pedroruizf/cansat/arduino/cansat_accesible.pdf

# CANSAT accesible con ArduinoBlocks y Processing

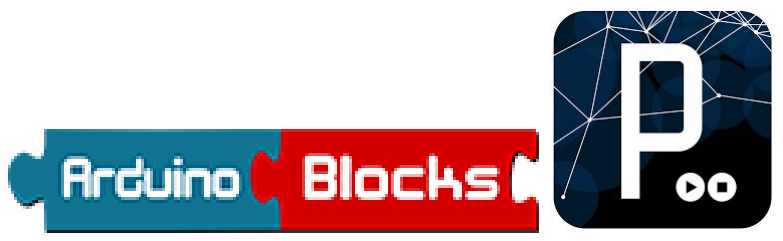
[picture p11: figure]

Por: Pedro Ruiz Fernández @pedroruizf

Con la colaboración inestimable de Equipo Sotosat (IES Pedro Soto de Rojas), Lorenzo Olmo, Manuel Hidalgo @leobotmanuel, y Pepe Alcaide

Versión 28/10/2020

Licencia

Nota Importante: La Información compartida en este documento está realizada por profesor y equipo novato en CANSAT, así como todo los dispositivos y su programación están en fase de pruebas, por tanto, hay que tomarla con cautela y provisionalidad.

Introducción | 2
Información general | 2
Paracaidas | 2
Cálculo | 2
Trazado | 3
Enlaces complementarios | 4
Estructura | 5
Comunicaciones por radio (antenas) | 6
Software | 7
Misión Primaria | 7
Solución Electrónica con Arduino | 7
Componentes y piezas: | 7
Pin-out de Cansat con Arduino Mega 2560 Pro Mini y esquema con fritzing | 10
Alimentación de Arduino Mega | 12
Programa en Arduinoblocks | 13
Programa de estación base (PC) en processing | 15
Misión Secundaria | 17
Telemetetría avanzada, tratatamiento y graficado de datos | 17
Proyecto científico | 19
Objetivos | 19
Imágenes | 19
Vídeos | 22
Webs de interés | 22
Cansat accesible | 1

# Introducción

Se trata del desarrollo del proyecto CANSAT de manera que la parte electrónica sea asequible en cuanto a coste y complejidad en cuanto a programación. Para ello hemos elegido una plataforma de control Arduino Mega 2560 pro mini programada bajo la aplicación web “Arduinoblocks”, programación gráfica basada en bloques, además se ha implementado en “Processing” un programa para la estación base que filtra los posibles datos erróneos y los datos correctos los guarda en un fichero, también en la estación base se produce el graficado de los diferentes datos con el graficador libre KST. Esta combinación hace que el coste del proyecto para misiones primarias y secundarias fáciles sean asequibles, así como la programación de las mismas.

# Información general

- Web del proyecto: http://esero.es/cansat/
- Presentación:
https://docs.google.com/presentation/d/1Iyj4ezujqL82Y-b0kIbfKxgbNGXrmlXl3QwgTSKNW3c/edit?usp=sharing (https://docs.google.com/presentation/d/1Iyj4ezujqL82Y-b0kIbfKxgbNGXrmlXl3QwgTSKNW3c/edit?usp=sharing)
- Requisitos: http://esero.es/cansat/requisitos/
- Recursos asociados: http://esero.es/cansat/recursos-asociados/

# Paracaidas

El paracaidas está en fase de pruebas y todavía no se han realizado lanzamientos de prueba.

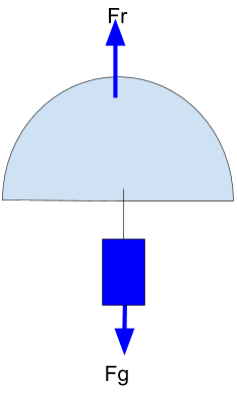
[picture p12: figure]

Cálculo
Datos de Cálculo: Masa cansat entre 300 y 350 g, Tiempo de vuelo recomendado máximo 120 s, Velocidad de descenso entre 6 y 12m/s (recomendadas entre 8 y 11m/s).
Para calcular vamos a igualar la fuerza de resistencia del paracaídas (Fr) a el peso que mueve el paracaídas (Fg=mg) hacia el suelo. Cuando estén igualadas deja de acelerar y la velocidad se convierte en constante, esa es la velocidad de caída.
ΣF = m.a, Fr − Fg = m.a, como Fr = Fg, 0 = m.a; a = 0
Fg=m.g (peso cansat).
Fr=½.r.Cd.A.V

2
(fuerza de resistencia del paracaídas)
- r = densidad del aire (1,22 Kg/m3)
- Cd = coeficiente de resistencia aerodinámico en paracaídas de forma hemiesférico su valor es 0,62.
- A = superficie del paracaídas (en nuestro caso semiesfera)
- V = velocidad de descenso
igualando las dos expresiones m.g = ½.r.Cd.A.V

2 de estas dos expresiones puedo despejar el área del paracaídas, A=2.(m.g)/r.Cd.V

2

Si la superficie del paracaídas es una semiesfera puedo calcular su diámetro, A=2.pi.R

2
, por tanto igualando
= | , despejando

2.m.g
r.Cd.V

2

2.Π.R

2 | R = √

m.g
r.Cd.V .Π

2
Para determinar la velocidad de caída y si la velocidad es constante (sin aceleración), tenemos que V=e/t, el cohete alcanza 1000 m de altura (espacio a recorrer) y el tiempo dijimos 120 s, por tanto …., ya tenemos la V, además tenemos la masa de nuestro cansat (de 300g a 350g), con lo cual ya tenemos todo para calcular nuestro radio o diámetro de paracaídas.

Trazado
Además hemos realizado una hoja de cálculo (https://drive.google.com/file/d/1-Z3dpShxpypyg2hHrPxrzzwptYT9jEAG/view?usp=sharing) para realizar los cálculos de la forma y dimensiones de nuestros gores (secciones) de nuestro paracaidas, en función del radio elegido y el número de secciones.
Cálculo de coordenadas:
- X=α.radio, posición x de los puntos del gore
- Y=(2.Π.radio.cosα)/(nº gores.2), posición y de los puntos del gore (hay dos una positiva y otra negativa simétricas)
radio (cm) | angulos (rad) (α) | angulos | x | y | y- | base
12 | 0 | 0 | 0 | 4,712388980384 69 | -4,712388980384 69 | 9,4247779607 6938
n.º gores | 0,174532 9251994 33 | 10 | 2,0943951023 932 | 4,640797203092 14 | -4,640797203092 14
8 | 0,349065 8503988 66 | 20 | 4,1887902047 8639 | 4,428197151140 32 | -4,428197151140 32
| 0,523598 7755982 99 | 30 | 6,2831853071 7959 | 4,081048569526 99 | -4,081048569526 99
| 0,698131 7007977 32 | 40 | 8,3775804095 7278 | 3,609899392238 8 | -3,609899392238 8
| 0,872664 6259971 65 | 50 | 10,471975511 966 | 3,029065248614 66 | -3,029065248614 66
| 1,047197 5511966 | 60 | 12,566370614 3592 | 2,356194490192 35 | -2,356194490192 35
| 1,221730 4763960 3 | 70 | 14,660765716 7524 | 1,611731954477 47 | -1,611731954477 47

1,396263 4015954 6 | 80 | 16,755160819 1456 | 0,818297758901 526 | -0,818297758901 526
1,570796 3267949 | 90 | 18,849555921 5388 | 2,885506040582 68E-16 | -2,885506040582 68E-16

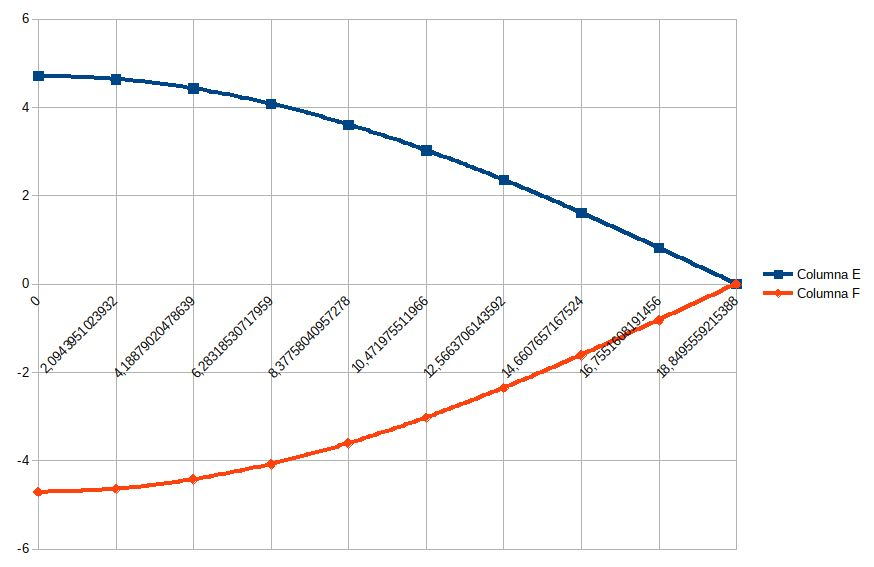
[picture p13: figure]

Enlaces complementarios
- Documento sobre paracaidas: http://esero.es/wp-content/uploads/2019/10/T10_Parachute_Design.pdf
- Calculo de paracaidas: http://www.rocketmime.com/rockets/descent.html
- Construcción | de | paracaidas | hemiesférico:
https://www.rocketreviews.com/making-a-hemispheric-nylon-parachute-9342.html
- Sitio de compra y cálculo (Fruity Chutes sita en Monte Sereno, CA, US): https://fruitychutes.com/
- Diseño y construcción de paracaidas: http://www.nakka-rocketry.net/paracon.html
- Hoja de cálculo para diseño: http://www.nakka-rocketry.net/soft/parapat_v1.1.xls
- Compra de tela: aquí (http://www.ventilador.com/ficha.asp?IdProducto=173&IdCategoria=5&IdSubCategoria=54&NumProdIni=1&vCat=5) (ancho 1,5 m, precio por metro lineal de ese ancho)

# Estructura

- Estructura Canduino: https://canduino.eu/index.php?id=3d-models (es la usada en la solución por ahora definitiva).
- Pequeña modificación a la tapa superior de canduino para pasar cable antena GPS: https://www.tinkercad.com/things/bsFOAFMVQrr
- Pequeña modificación de la tapa inferior para dejar ventana para el receptor de infrarrojo: https://www.tinkercad.com/things/5xsrRgHKRlN
- Pequeña modificación de la base principal (board 1) para dejar hueco para soldar pines Vin u gnd de alimentación: https://www.tinkercad.com/things/jOn9D70C28O

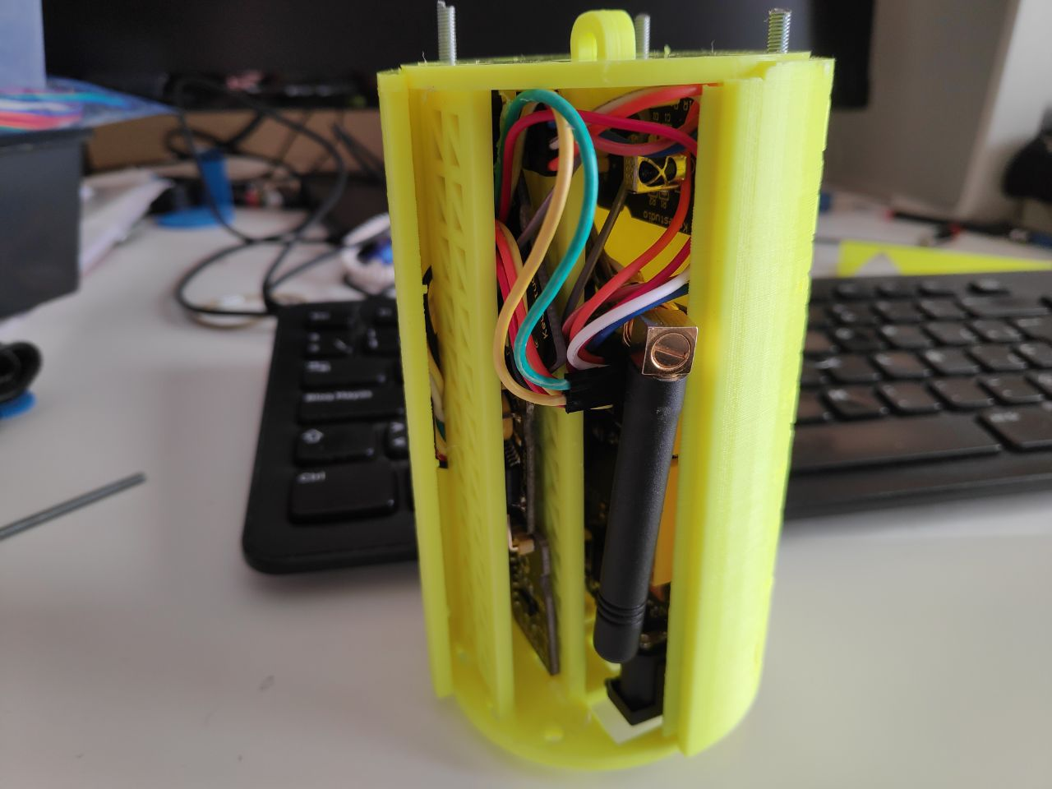
[picture p14: figure]

- Estructura | oficial | “cansat” | stl:
http://esamultimedia.esa.int/docs/edu/3d_printer_files_for_Cansat_case.zip, la estructura tiene los archivos shell (recipiente exterior), que se imprime dos veces y shield que es la bandeja separadora para colocar componentes electrónicos y de control.

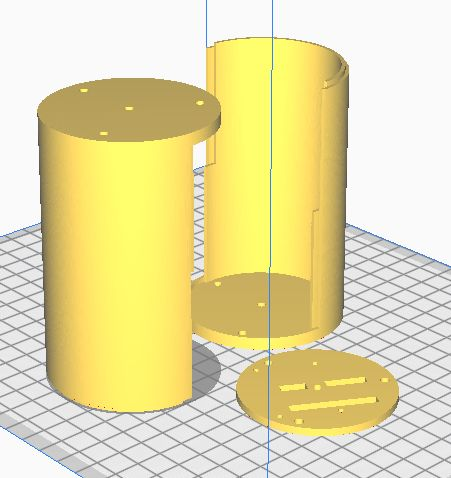
[picture p15: figure]

# Comunicaciones por radio (antenas)

El sistema está compuesto por emisor de radiofrecuencia APC220 a 434 Mhz situado en el cuerpo del cansat,
con | una | antena | con | conector | SMA | y | de | longitud | 17,3 | cm | (ver | web
(https://www.narom.no/undervisningsressurser/the-cansat-book/the-primary-mission/cansat-mechanics-design/antenna-design/), (https://www.narom.no/undervisningsressurser/the-cansat-book/the-primary-mission/cansat-mechanics-design/antenna-design/) y un receptor APC200 con adaptador serie-usb para conectarlo al PC. La antena que lleva el receptor es una de ¼ de onda omnidireccional. La transmisión se ha ajustado a una velocidad de 2400 baudios y a nivel de potencia 9 para un mayor alcance, para el ajuste de los dispositivos del kit APC220 hemos usado esta web (http://beetlecraft.blogspot.com/2015/10/tutorial-apc220.html).
Para el cálculo de la longitud de la antena emisora se usa la fórmula, L = , dónde c es la velocidad de la luz
| | | | | | | | c 4f
y f la frecuencia de transmisión en Hertzios (Hz), por tanto L = | , 73 m | 7, cm .

3.10 m/s

8
4 (434.10 1/s)
6 | = 0 1 | = 1 3
Para construir la antena se corta un cable coaxial con conector SMA y se desenfunda 17,3 cm, dejando sólo el cable central con su funda y quitando el resto.

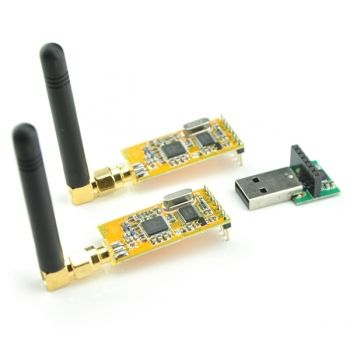
[picture p16: figure]

Documentación:

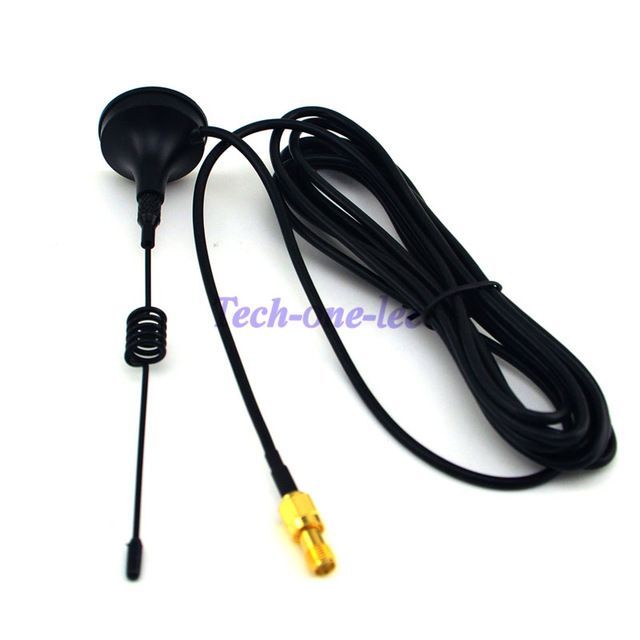
[picture p17: figure]
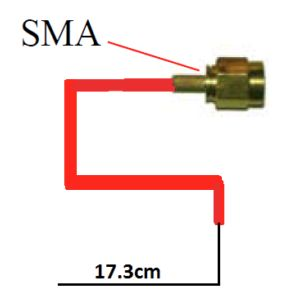
[picture p18: figure]

- Documento: http://esero.es/wp-content/uploads/2019/10/T11_Radio_Communication.pdf
- Construcción | | | antena | | | emisor | apc220:
https://www.narom.no/undervisningsressurser/the-cansat-book/the-primary-mission/cansat-mechanics-design/antenna-design/ (https://www.narom.no/undervisningsressurser/the-cansat-book/the-primary-mission/cansat-mechanics-design/antenna-design/)
- Configuración APC220: http://beetlecraft.blogspot.com/2015/10/tutorial-apc220.html
- Piezas | para | carcasa | de | receptor | de | radiofrecuencia | APC220:
https://www.thingiverse.com/thing:643721

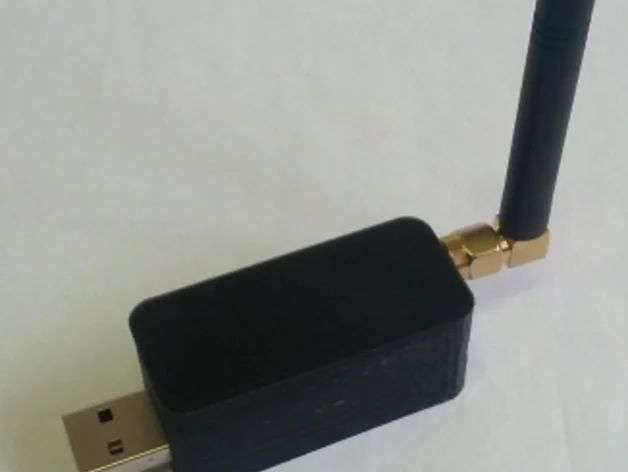
[picture p19: figure]

# Software

- Arduinoblocks: (http://www.arduinoblocks.com/web/) maravilloso entorno gráfico de programación online de diferentes plataformas arduino.
- Processing: (https://processing.org/) lenguaje de programación en el que se basa Arduino, con el nos comunicaremos por puerto serie para recibir datos en el ordenador y filtrar los correctos.
- KST (https://kst-plot.kde.org/) (graficado en tiempo real): programa para realizar graficado en tiempo real.

# Misión Primaria

Solución Electrónica con Arduino
Dicha solución está operativa y funcionando, queda por realizarle pruebas de alcance en la radiotransmisión.

### Componentes y piezas:

Item | Descripción | Imagen | Cantidad | Pin OUT | Compr a

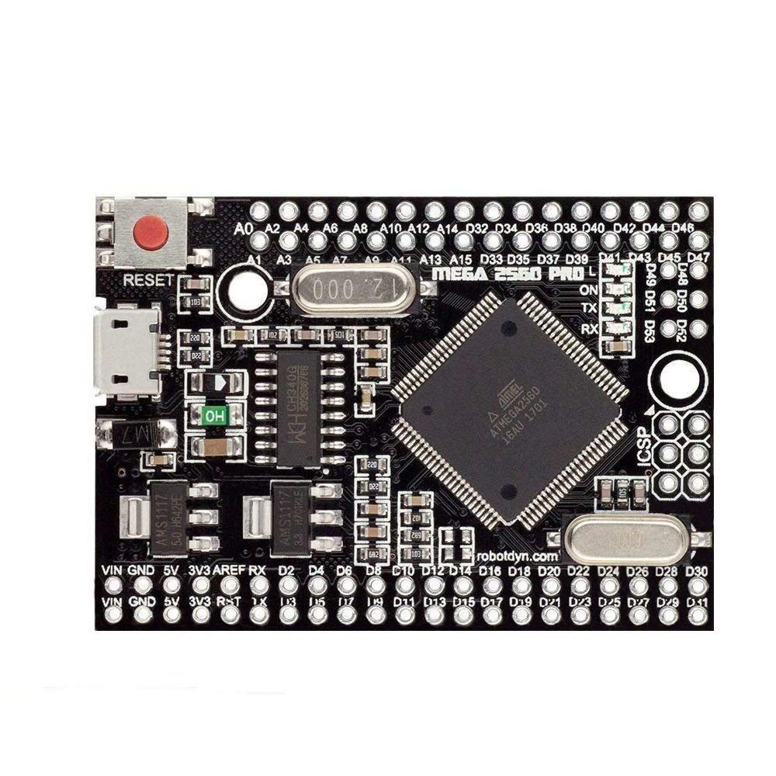
[picture p20: figure]

1 | Arduino Mega 2560 Pro Mini | | 1 | . | Aquí (https://www.amazon.es/gp/product/B07MQ1J9MR/ref=ppx_yo_dt_b_asin_title_o00_s00?ie=UTF8&psc=1)
2 | Acelerómetro ADXL345 (https://wiki.keyestudio.com/index.php/Ks0012_keyestudio_ADXL345_Three_Axis_Acceleration_Module) | | 1 | I2C: sda (20), scl (21), GND, VCC | Aquí (http://shop.innovadidactic.com/index.php?id_product=605&controller=product) o Aquí (https://solectroshop.com/product-spa-280-ADXL345-Acelerometro-3-Ejes-SPI-e-I2C.html)

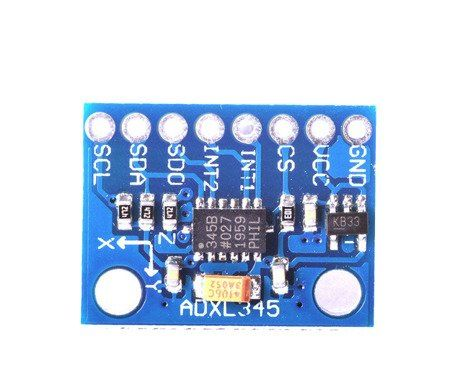
[picture p21: figure]
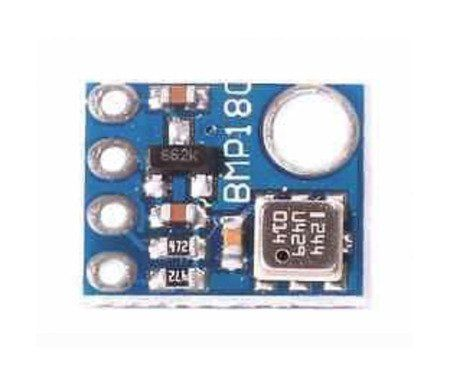
[picture p22: figure]

3 | Sensor presión, temperatura y altitud BMP180 (https://wiki.keyestudio.com/Ks0054_keyestudio_BMP180_Digital_Barometric_Pressure_Sensor_Module_for_Arduino) | | 1 | I2C: sda (20), scl (21), GND, VCC | Aquí (https://solectroshop.com/product-spa-292-BMP180-Modulo-Sensor-Barometrico-y-Temperatura-Presion.html)

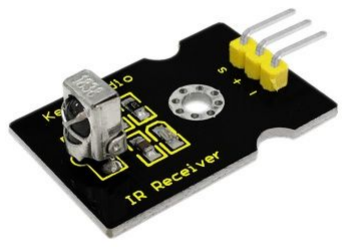
[picture p23: figure]

4 | Receptor de IR (https://wiki.keyestudio.com/Ks0026_keyestudio_Digital_IR_Receiver_Module) | 1 | GND,VCC, Signal (D2) | Aquí (https://solectroshop.com/product-spa-644-Mando-Distancia-IR-Receptor-IR-Infrarrojo-VS1838.html)

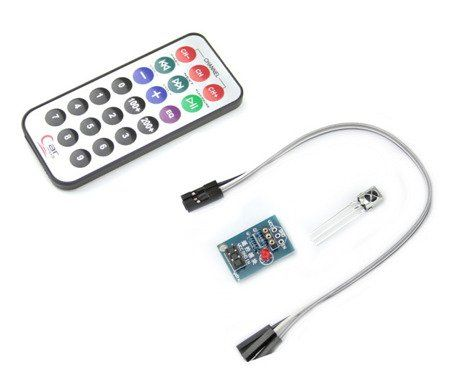
[picture p24: figure]
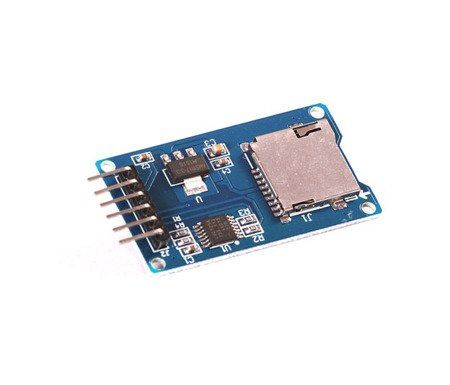
[picture p25: figure]

5 | Modulo tarjeta microSD por SPI | 1 | GND,VCC, CS (D4), MOSI (51), SCK (52), MISO (50) | Aquí (https://solectroshop.com/product-spa-655-Arduino-Modulo-Lector-Grabador-Micro-SD.html)
6 | Emisor y receptor (en PC) de radiofrecuencia APC220 (https://tuelectronica.es/arduino-y-modulo-inalambrico-rf-apc220/) | 1 | GND, VCC, RX (TX), TX (RX) | Aquí (https://es.banggood.com/APC220-Wireless-Data-Communication-Module-USB-Adapter-Kit-For-Arduino-p-939407.html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)

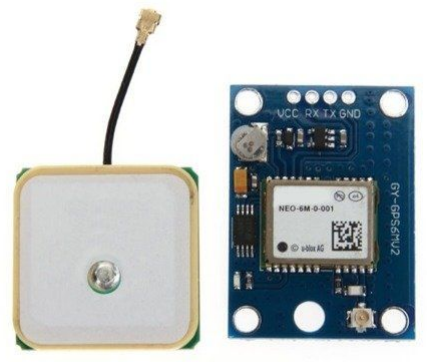
[picture p26: figure]

7 | GPS | 1 | GND, VCC, RX (D10), TX (D11) | Aquí (https://solectroshop.com/product-spa-1485-Modulo-GPS-Ublox-GY-GPS6MV2-NEO6MV2-EEPROM-con-Antena.html) o Aquí (https://www.amazon.es/AZDelivery-Shield-Ethernet-electr%C3%B3nico-gratuito/dp/B079SXZ2TF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)
8 | Piezas estructura canduino | 1 juego | | Aquí (https://canduino.eu/index.php?id=3d-models)

9 | Carcasa receptor APC220 | 1 juego | Aquí (https://www.thingiverse.com/thing:643721)

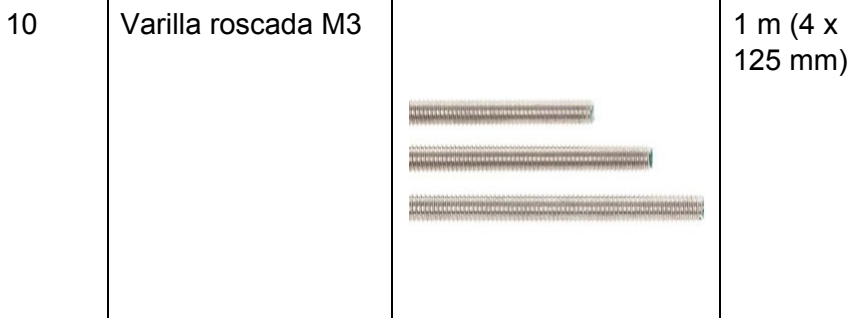
[picture p27: figure]
Varilla roscada M3
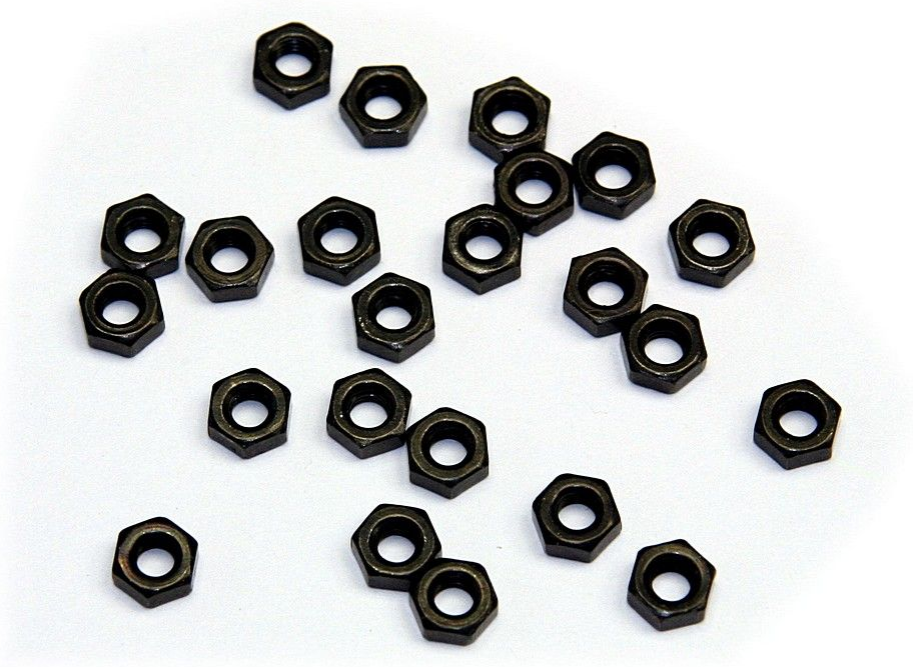
[picture p28: figure]

11 | Tuercas M3 | 8

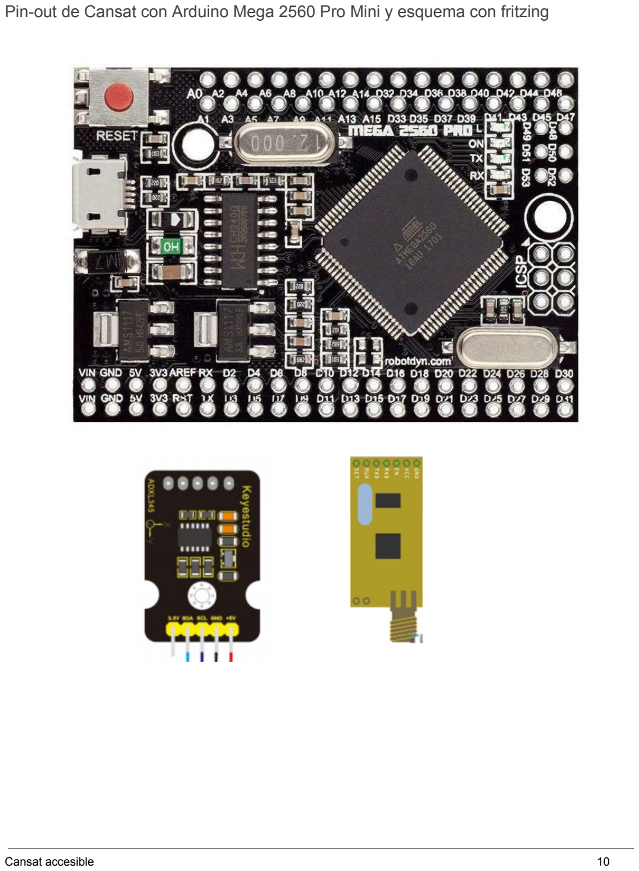
[picture p29: page 11]

### Pin-out de Cansat con Arduino Mega 2560 Pro Mini y esquema con fritzing

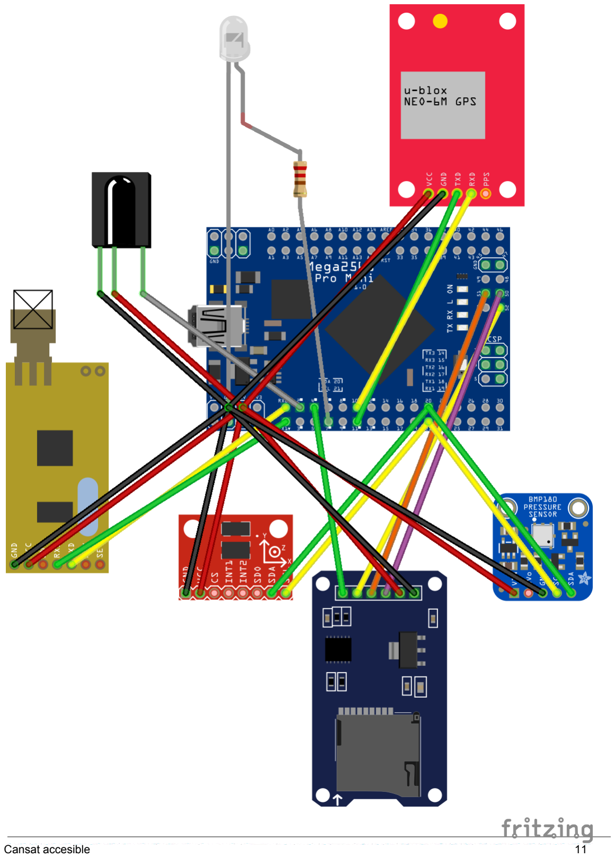
[picture p30: page 12]

### Alimentación de Arduino Mega

La alimentación de cansat es a través de una pila de 9V conectada a microinterruptor de conmutador doble, como se muestra en la figura:

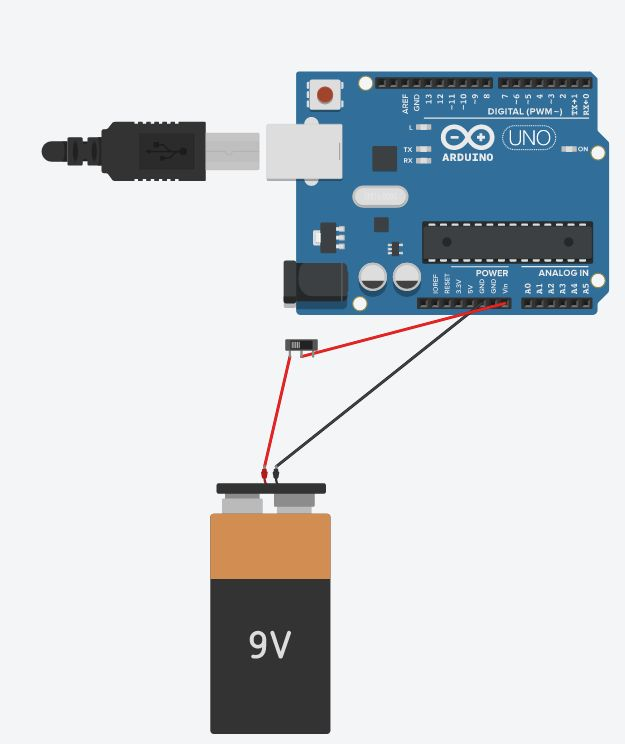
[picture p31: figure]

### Programa en Arduinoblocks

Proyecto compartido para arduino mega (V1): http://www.arduinoblocks.com/web/project/223835
Dicho programa inicializa el la función setup (inicializar) parámetros como variables, la velocidad de transmisión, el gps, la inicialización de la SD y enciende el led asociado al pin 13.
En el bucle principal leemos el valor del sensor de infrarrojo, si es un determinado valor cambia el valor de la variable booleana graba. Si graba es cierto apaga el led del pin 13 y deja el sistema preparado para cada segundo leer los sensores, grabarlos en la microsd y enviarlos por puerto serie por la radiofrecuencia.
Si graba es falso enciende el led del pin13.

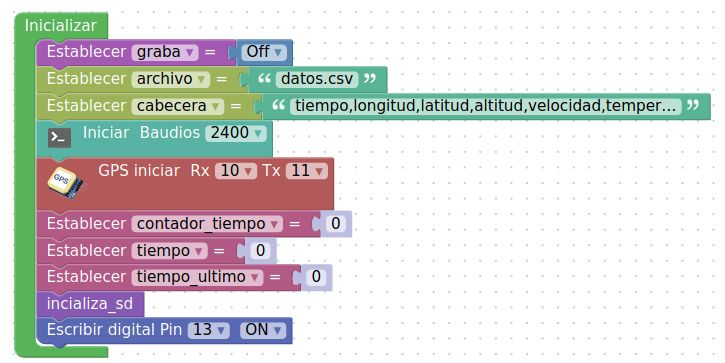
[picture p32: figure]
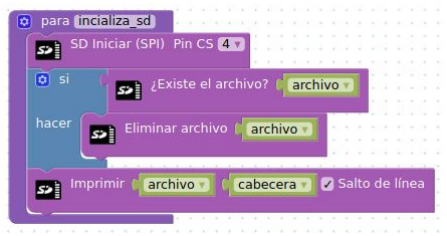
[picture p33: figure]
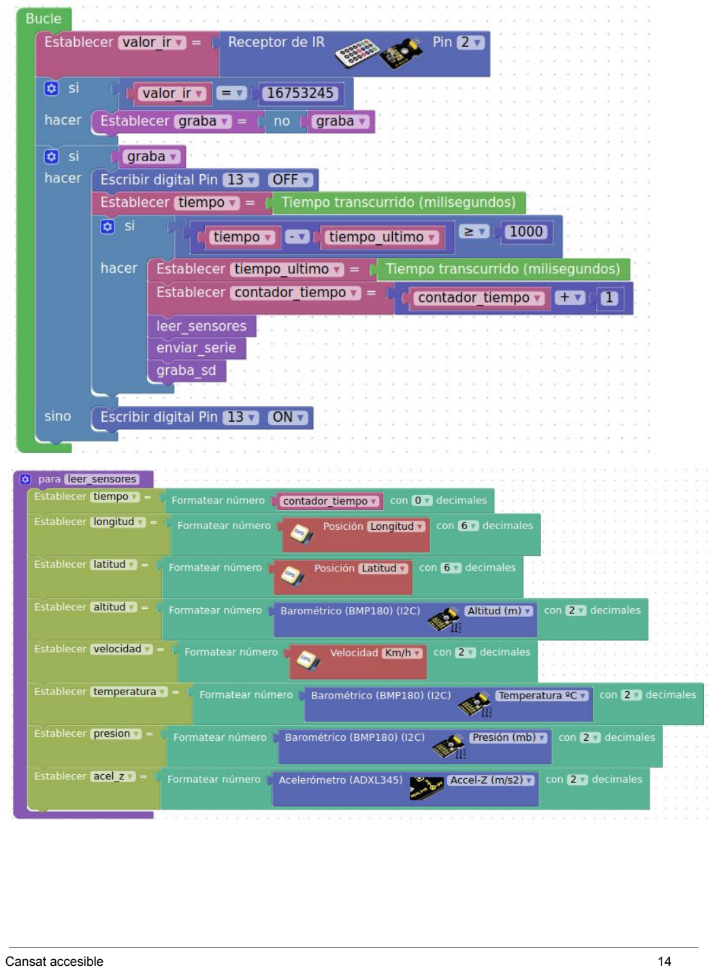
[picture p34: page 15]

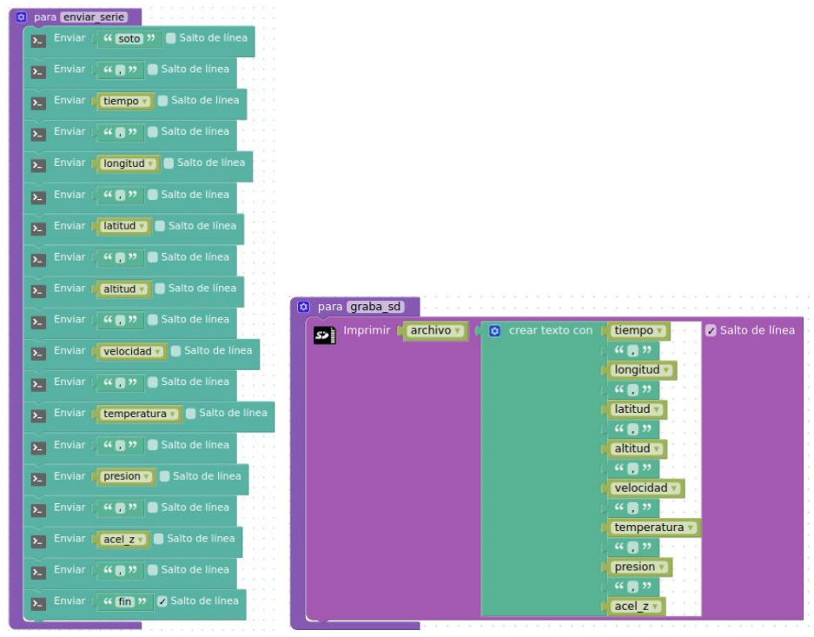
[picture p35: figure]

### Programa de estación base (PC) en processing

El siguiente programa (descargar aquí) (https://drive.google.com/file/d/1h5Gw03SzC58vAIHrscAUBQ4DusNBqbN4/view?usp=sharing) se ejecuta en el PC, establece comunicación con el puerto serie (APC200 receptor pinchado en USB), filtra los posibles datos erróneos que provengan de cansat usando tres comprobaciones: verifica que la cantidad de campos que hay en cada registro sean 10, verifica que el primer y el último campo tengan un valor determinado, en nuestro caso primer campo “soto” y el último campo “fin”. Más tarde con los datos ya filtrados los guarda en un fichero y los muestra en consola y ventana.

import processing.serial.*;

Serial puerto;//establece variable puerto tipo Serial
PrintWriter fichero;//establece variable fichero tipo PrintWriter (fichero) int contador=0;//variable para contar el nº de grabaciones realizadas

void setup() {
//println(Serial.list());
size (400, 335);
background(0);

puerto = new Serial(this, Serial.list()[32], 9600);//establece la variable puerto asignando el receptor APC200 y una velocidad de 9600 baudios
fichero=createWriter("datos.csv");//crea el fichero datos.csv
datosPantalla("Sin datos", "Sin datos", "Sin datos", "Sin datos", "Sin datos", "Sin datos", "Sin datos", "Sin datos");
}

void draw() {

datosPantalla("Sin datos", "Sin datos", "Sin datos", "Sin datos", "Sin datos", "Sin datos", "Sin datos", "Sin datos");

while (puerto.available()>0) {//mientras haya datos en el puerto serie
String buffer=puerto.readStringUntil(10);//leemos los datos del puerto serie hasta el salto de línea (10 en ascii), y los asignamos a buffer

if (buffer!=null) {//si buffer no está vacío
String[] listaBuffer = split(buffer, ',');//extrae en un array los elementos separados por coma del buffer int longitudBuffer=buffer.length();//leemos el nº de caracteres del buffer
int numeroCampos=listaBuffer.length;//leemos el nº de campos que están en el array, deben ser 10 //println (buffer);
println ("el nº de campos es:" + numeroCampos + " el nº de caracteres es:" + longitudBuffer);//imprimimos en consola el nº de campos y nº de caracteres recibidos

if (numeroCampos==10 && listaBuffer[0].equals("soto")==true && listaBuffer[9].equals("fin\r\n")==true) {//grabamos si hay 10 campos y los campos de control de inicio y fin son correctos
contador++;
fichero.print(buffer);//colocamos en el fichero el buffer
fichero.flush();//hacemos la grabación efectiva y se cierra el fichero
println(buffer);//imprimimos por consola lo grabado
datosPantalla(listaBuffer[1], listaBuffer[2], listaBuffer[3], listaBuffer[4], listaBuffer[5], listaBuffer[6], listaBuffer[7], listaBuffer[8]);//llamamos a la función que nos pone en pantalla los datos recogidos
} else {
datosPantalla("Sin datos", "Sin datos", "Sin datos", "Sin datos", "Sin datos", "Sin datos", "Sin datos", "Sin datos");
}
}
}
}

void datosPantalla(String tiempo, String longitud, String latitud, String altitud, String velocidad, String temperatura, String presion, String acelz) {
background(0);
textSize (24);
text ("Datos SotoSat", 120, 35); textSize(16);
text ("Tiempo(s):"+ tiempo, 50, 75);

text ("Longitud:"+longitud, 50, 100); text ("Latitud:"+latitud, 50, 125);
text ("Altitud (m):"+altitud, 50, 150);
//text ("Rumbo:"+rumbo, 50, 175);
text ("Velocidad (Km/h):"+velocidad, 50, 175); text ("Temperatura (ºC):"+temperatura, 50, 200); text ("Presión (mb):"+presion, 50, 225);
text ("Acel. z (m/s2):"+acelz, 50, 250);
//text ("Día:"+dia, 50, 100);
//text ("Hora:"+hora, 50, 125);
}

# Misión Secundaria

Telemetetría avanzada, tratatamiento y graficado de datos
La misión secundaria que se aborda con este proyecto pretende ser de bajo coste y exportable al mayor número de situaciones, para ello se han escogido tres vías de actuación:
- Realizar telemetría avanzada usando sensores de bajo costo: posicionamiento gps, aceleración, velocidad, etc.
- Filtrado de datos en la estación base: se trata de un programa de processing en el PC de la estación base que recibe los datos en crudo de la emisión de cansat y los filtra detectando registros (tramas) incorrectas, para ello realiza tres comprobaciones que se deben cunplir a la vez, que el número de campos recibidos sea el correcto, que el campo de control de inicio se cumpla y que el campo de control final se cumpla. Con este filtrado conseguimos que los datos que no son correctos por fallos de transmisión (perdida de comunicación por falta de alcance en la emisión-recepción, interferencias) no lleguen al graficador en tiempo real que provocarían un mal graficado.
- Realizar el graficado con KST de los datos previamente filtrados presentando una gráfica por cada dato de telemetría recibida, siendo el eje X de todas las gráficas el tiempo de ejecución del lanzamiento.

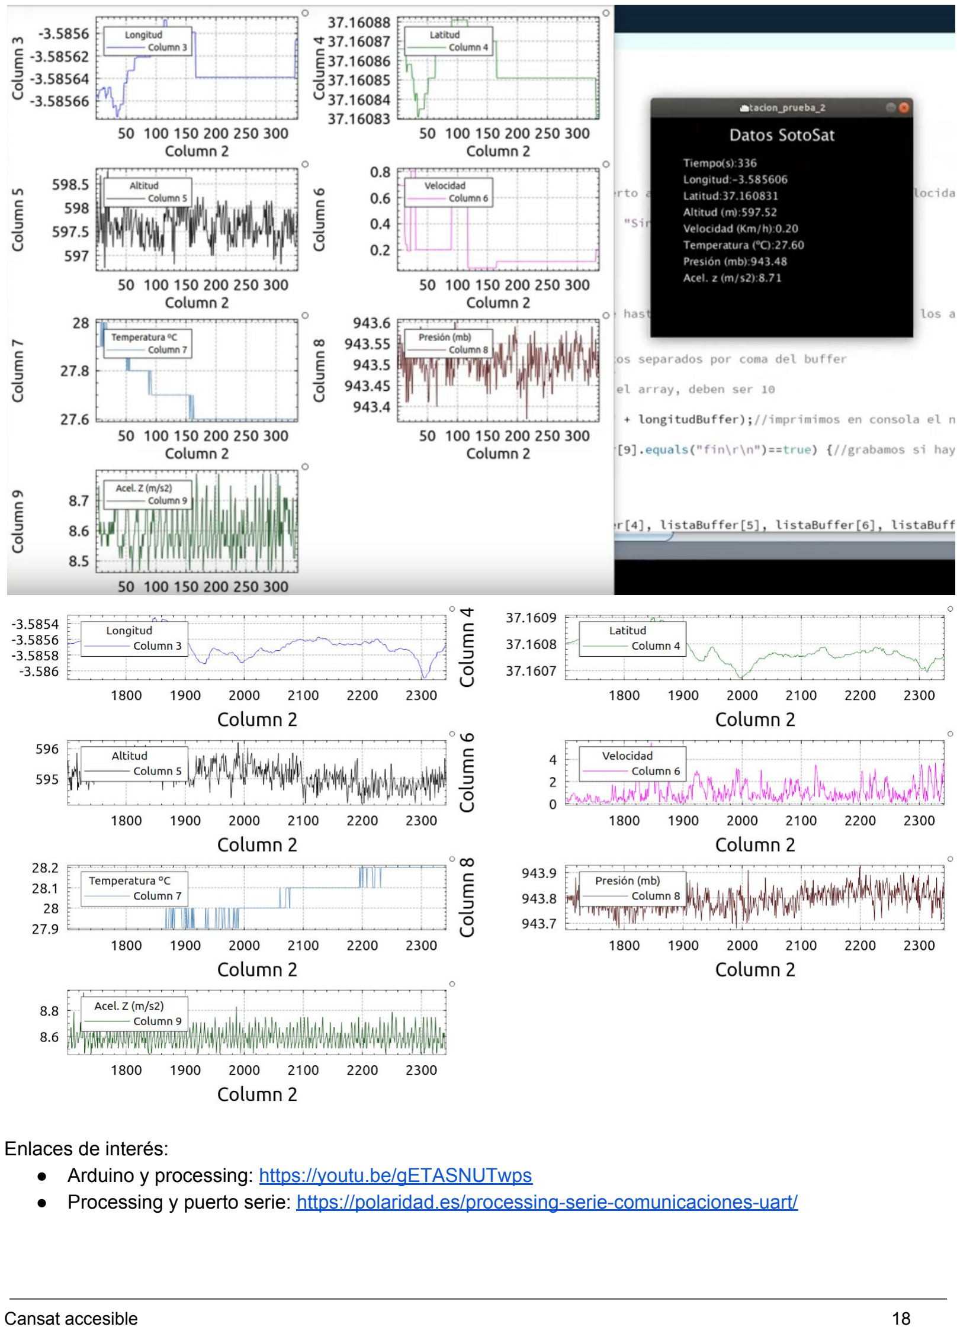
[picture p36: page 19]

Enlaces de interés:
- Arduino y processing: https://youtu.be/gETASNUTwps
- Processing y puerto serie: https://polaridad.es/processing-serie-comunicaciones-uart/

# Proyecto científico

Objetivos
- Graficar e interpretar variaciones de altura y presión: comprobar que a mayor altura menor presión y viceversa.
- Graficar e interpretar variaciones de altura y temperatura: comprobar que a mayor altura menor temperatura.
- Graficar e interpretar la aceleración en Z: comprobamos el diseño del paracaidas, que ha sido calculado para que el movimiento de descenso se M.R.U (movimiento uniforme a velocidad constante) por tanto la aceleración en Z debe ser en torno a 0 m/s2.

# Imágenes

Enlaces a Imágenes (https://drive.google.com/drive/folders/1TRe7W4DNOKoN24Tx622zMlaU37y-YG29?usp=sharing)

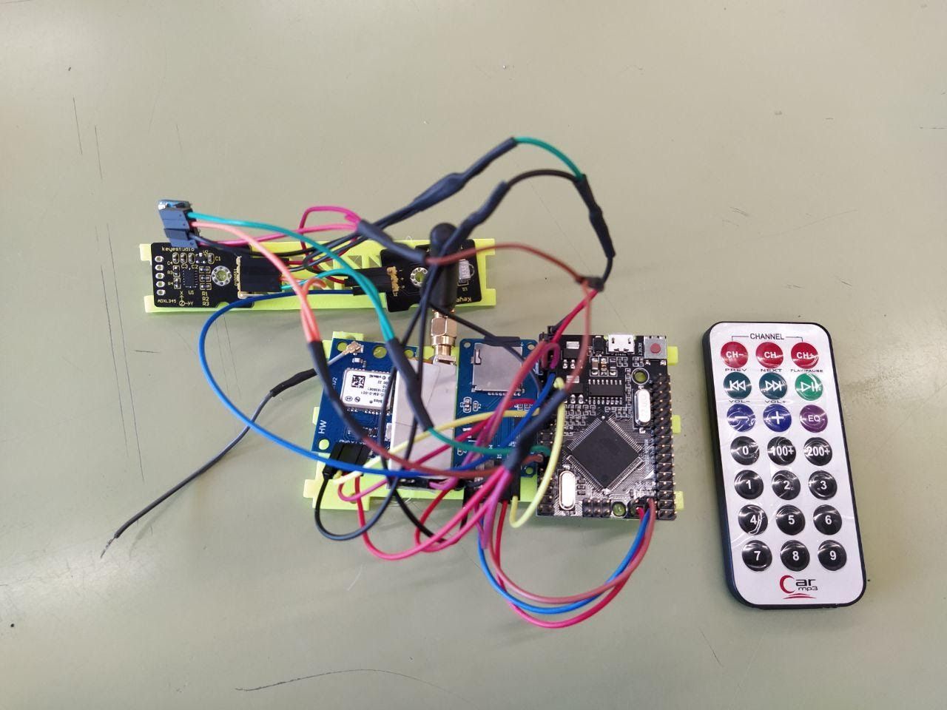
[picture p37: figure]
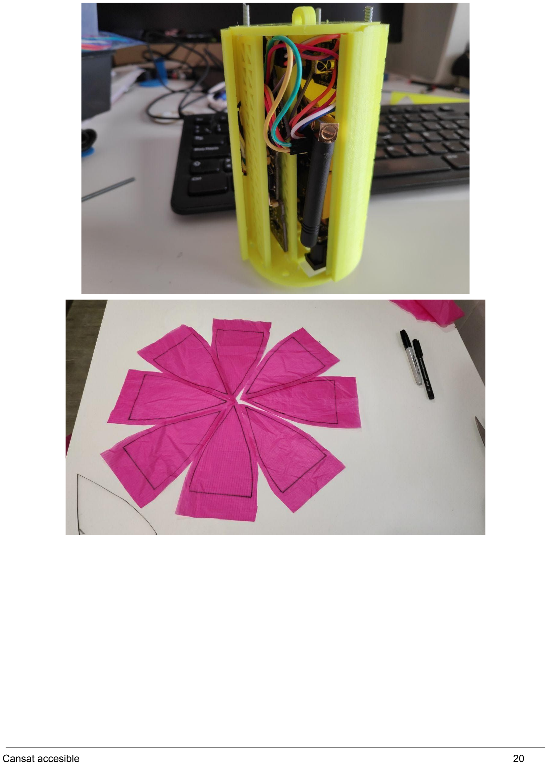
[picture p38: page 21]
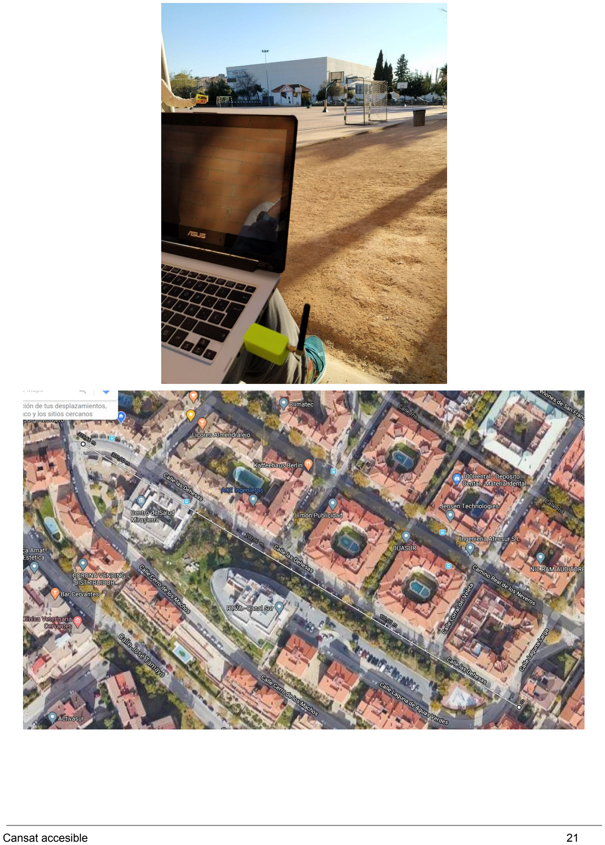
[picture p39: page 22]

# Vídeos

- Prueba de graficado de telemetría con filtrado de datos: https://youtu.be/t9S8PFPLkVA
- Pruebas de paracaidas:
- https://youtu.be/uHOaMot1JTM
- https://youtu.be/Mxxc1lZZjkk

# Webs de interés

- https://www.youtube.com/playlist?list=PLwagIiYuh5RYOJNwSjlyMwnosqbO2Qryl
