pedroruizf/cansat/(commit log)

2020-06-28 añadidos recursos de software para microbit
2020-06-29 añadido manual y comentarios en programa principal de microbit
2020-06-29 cambios en la portada del manual
2020-07-10 añadido foto de montaje de cansat microbit
2020-10-28 cambios en enlaces a piezas de cansat
